KingFish233/ArduF405_Hardware/CutingEdge.dxf

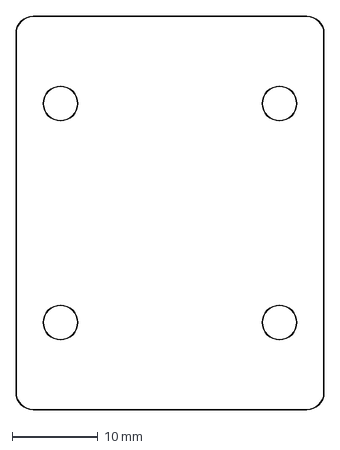
[picture p1: CAD file, 2026-08-20]
CutingEdge.dxf
35.8 x 45.8 mm
