KingFish233/ArduF405_Hardware/(list of files, cad)

Other CAD files:
CUTING_EDGE.dxf
