KingFish233/ArduF405_Hardware/(commit log)

2026-08-15 首次提交
    [ArduF405_Hardware.kicad_pcb, ArduF405_Hardware.kicad_sch, CUTING_EDGE.dxf]
2026-08-17 完成原理图绘制
    [ArduF405_Hardware.kicad_pcb, ArduF405_Hardware.kicad_sch]
2026-08-20 完成PCB板设计
    [ArduF405_Hardware.kicad_pcb, ArduF405_Hardware.kicad_sch, CutingEdge.dxf]
2026-08-20 添加丝印
    [ArduF405_Hardware.kicad_pcb]
2026-08-22 细节修改，led表示错误修正
    [ArduF405_Hardware.kicad_sch, bom.csv, bom_jlc.csv, designators.csv, positions.csv]
2026-09-13 添加硬件定义文件
2026-09-13 过程文件变化
